Alberto-M11/Alberto_Mendez_Electiva_2026_C2/Tarea 1/Resumen MBSE.jpeg

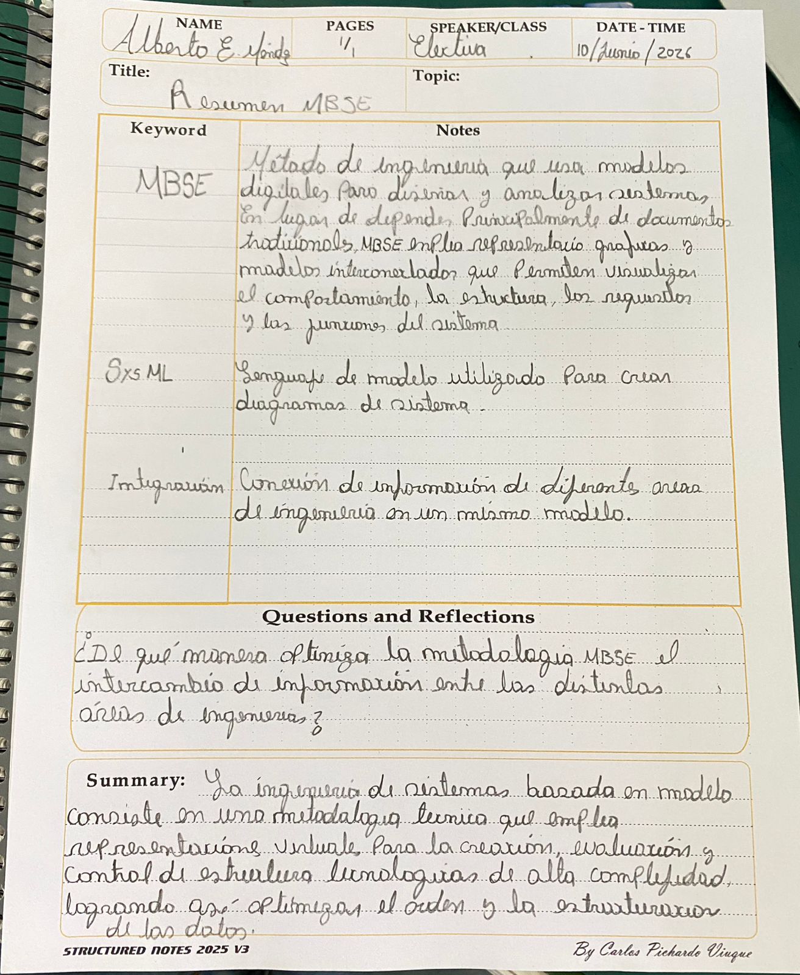
Tarea 1/Resumen MBSE.jpeg
