Alberto-M11/Alberto_Mendez_Electiva_2026_C2/README.md

# Alberto_Mendez_Electiva_2026_C2
Entrega de trabajos realizados en la materia.
