Alberto-M11/Alberto_Mendez_Electiva_2026_C2/Tarea 2/Dimensiones del PLC.jpeg

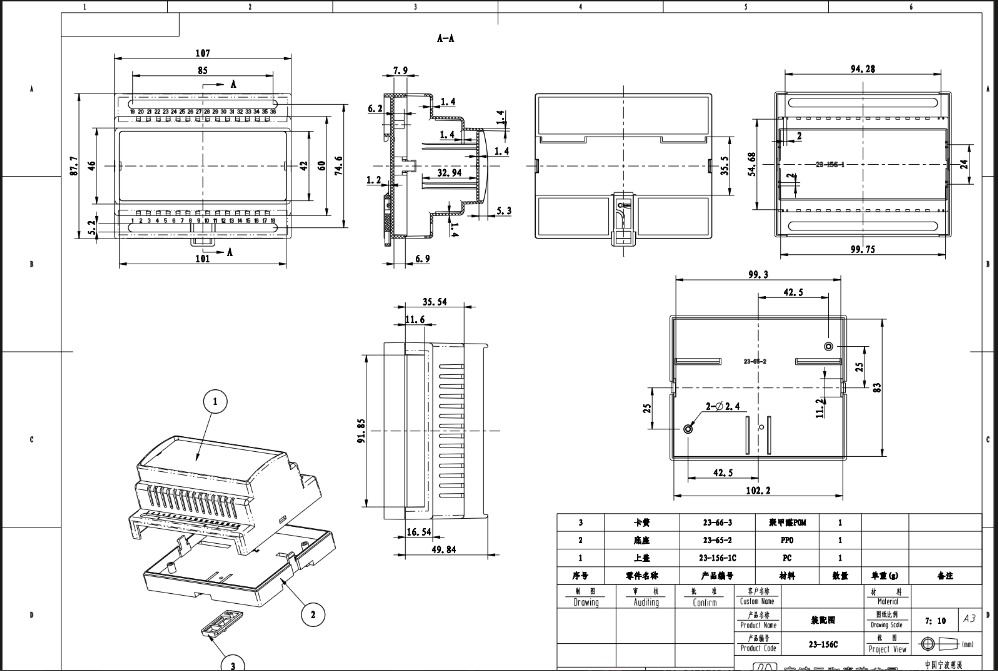
Tarea 2/Dimensiones del PLC.jpeg
