Alberto-M11/Alberto_Mendez_Electiva_2026_C2/Tarea 2/Parte Superior.FCStd

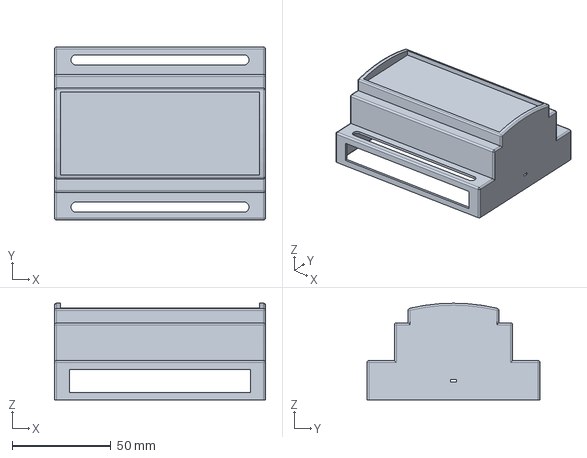
[picture p4: CAD file, 2026-07-27]
Tarea 2/Parte Superior.FCStd
107.0 x 87.7 x 49.0 mm
