Alberto-M11/Alberto_Mendez_Electiva_2026_C2/Tarea 2/Base del PLC.FCStd

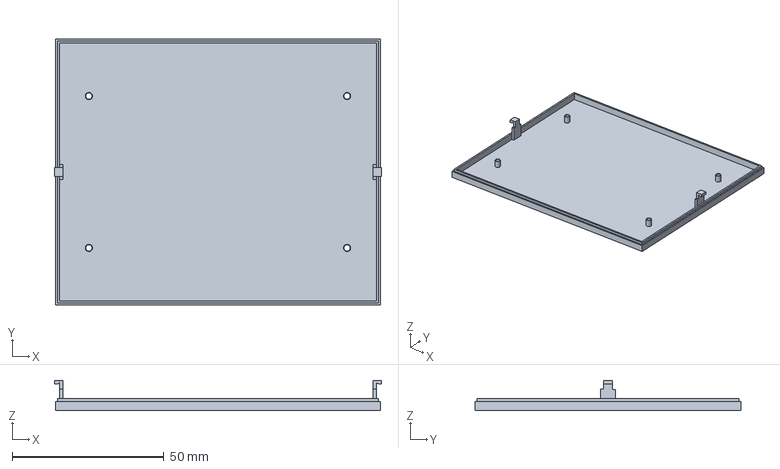
[picture p6: CAD file, 2026-06-11]
Tarea 2/Base del PLC.FCStd
107.6 x 87.7 x 10.0 mm
