Alberto-M11/Alberto_Mendez_Electiva_2026_C2/Tarea 2/Parte Superior en proceso.FCStd

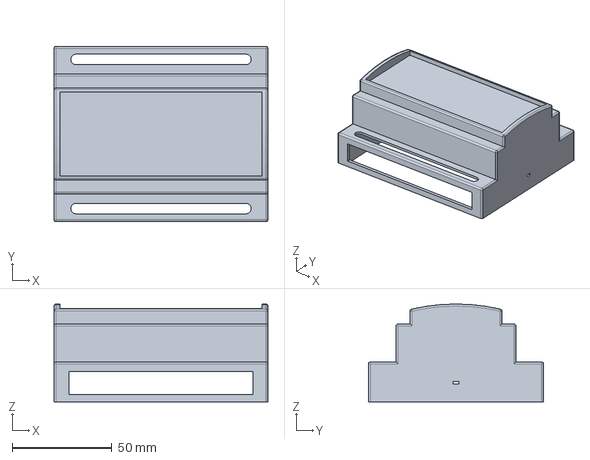
[picture p7: CAD file, 2026-06-11]
Tarea 2/Parte Superior en proceso.FCStd
107.0 x 87.7 x 49.0 mm
