Alberto-M11/Alberto_Mendez_Electiva_2026_C2/Tarea 5/PLC4UNI-GC1_3D/Base Del Case Plástico.FCStd

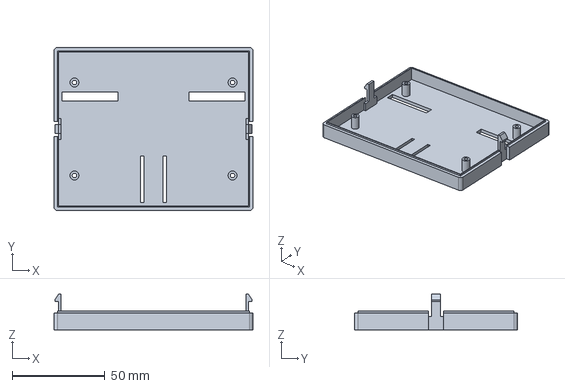
[picture p8: CAD file, 2026-08-04]
Tarea 5/PLC4UNI-GC1_3D/Base Del Case Plástico.FCStd
107.0 x 87.7 x 19.1 mm
