Alberto-M11/Alberto_Mendez_Electiva_2026_C2/Tarea 5/PLC4UNI-GC1_3D/PLC4UNI-PCB.FCStd

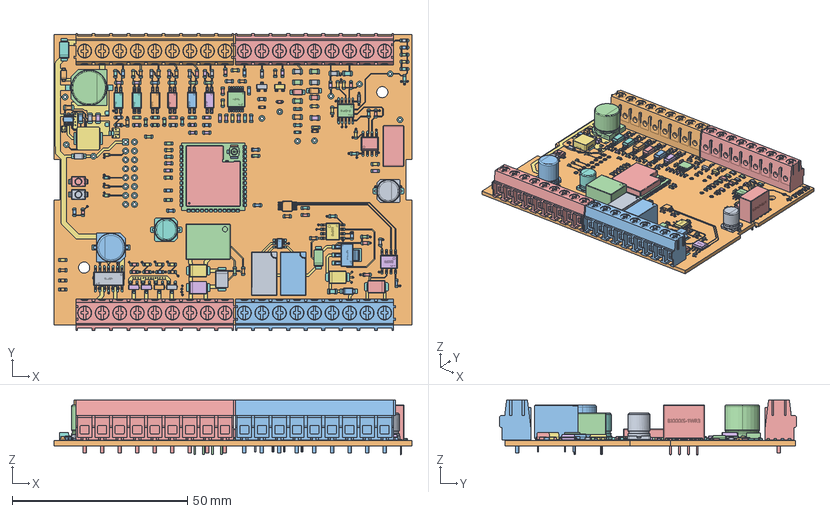
[picture p9: CAD file, 2026-08-04]
Tarea 5/PLC4UNI-GC1_3D/PLC4UNI-PCB.FCStd
102.1 x 84.7 x 15.6 mm
R_0603_1608Metric
R_0603_1608Metric002
CAP-SMD_BD8.0-L8.3-W8.3-FD
R_0603_1608Metric004
R_0603_1608Metric006
ESOP-8_L4.9-W3.9-H1.6-LS6.0-P1.27
C_0603_1608Metric
C_0603_1608Metric002
LED_0603_1608Metric
LED_0603_1608Metric002
LED_0603_1608Metric004
C_0603_1608Metric004
R_0805_2012Metric
R_0603_1608Metric008
IND-SMD_L7.0-W6.6_APH0630
R_0603_1608Metric010
LED_0603_1608Metric006
C_0805_2012Metric
SOD-123_L2.8-W1.8-LS3.9-FD
R_0603_1608Metric012
R_0603_1608Metric014
SOT-23-3
C_0603_1608Metric006
C_0603_1608Metric008
R_0603_1608Metric016
TerminalBlock_Phoenix_PT-1,5-9-5.0-H_1x09_P5.00mm_Horizontal
LED_0603_1608Metric008
COMM-TH_L12.7-W10.2-H7.7-TD301M485
LED_0603_1608Metric010
R_0603_1608Metric018
D_SMB
SSOP-4_L2.7-W4.6-P1.27-LS7.0-TL
R_0805_2012Metric002
SOD-123_L2.7-W1.6-LS3.7-RD-2
Relay_SPDT_Omron_G5V-1
R_0805_2012Metric004
R_0603_1608Metric020
D_SMB002
R_0603_1608Metric022
R_0805_2012Metric006
C_0603_1608Metric010
D_SOD_523
R_0603_1608Metric024
R_0805_2012Metric008
TerminalBlock_Phoenix_PT-1,5-9-5.0-H_1x09_P5.00mm_Horizontal002
SOT-23-002
C_0603_1608Metric012
SSOP-4_L2.7-W4.6-P1.27-LS7.0-TL002
Relay_SPDT_Omron_G5V-002
R_0603_1608Metric026
SOT-223-4P_L6.5-W3.5-H1.6-LS7.0-P2.30
R_0603_1608Metric028
SOD-123_L2.7-W1.6-LS3.7-RD-001
R_0603_1608Metric030
D_SOD_524
C_0603_1608Metric014
SOT-23-004
R_0603_1608Metric032
R_0603_1608Metric034
R_0805_2012Metric010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
