Alberto-M11/Alberto_Mendez_Electiva_2026_C2/(list of files, cad)

Other CAD files:
Tarea 5/PLC4UNI-GC1_3D/PLC4UNI-Assembly.step
Tarea 5/PLC4UNI-GC1_3D/PLC4UNI_MEZZANINE.step
Tarea 5/PLC4UNI-GC1_3D/PLC4UNI.step
Tarea 5/PLC4UNI-GC1_3D/PLC4UNI.FCStd
Tarea 5/PLC4UNI-GC1_3D/PLC4UNI_MEZZANINE.FCStd
