Alberto-M11/Alberto_Mendez_Electiva_2026_C2/Tarea 5/BASE DE PLASTICO PLC4UNI Dimensiones.pdf

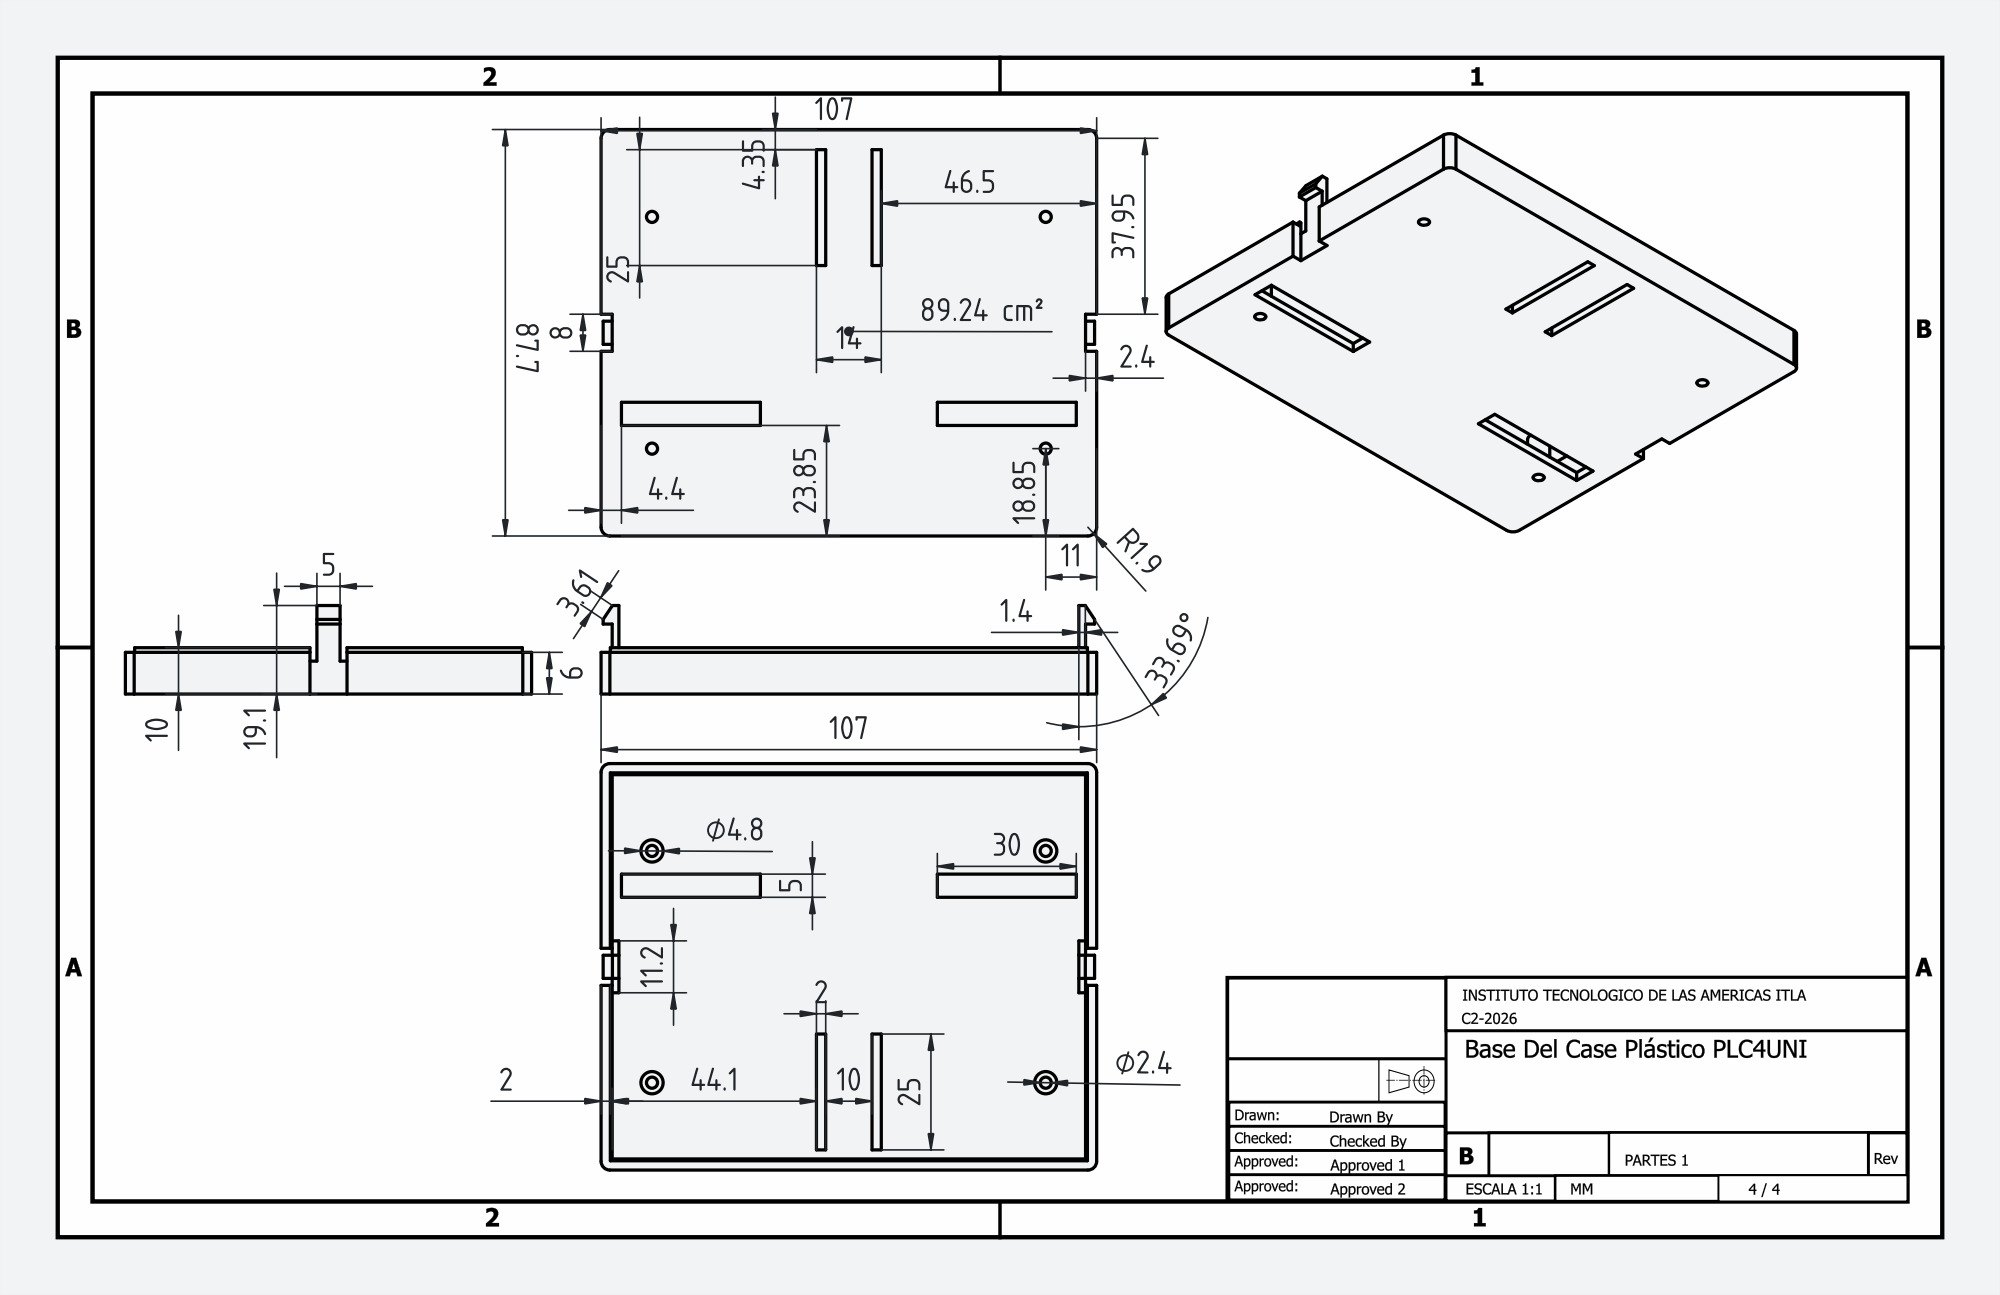
[picture p10: page 1]
