Alberto-M11/Alberto_Mendez_Electiva_2026_C2/Tarea 5/TAPA CASE DE PLASTICO PLC 4UNI.pdf

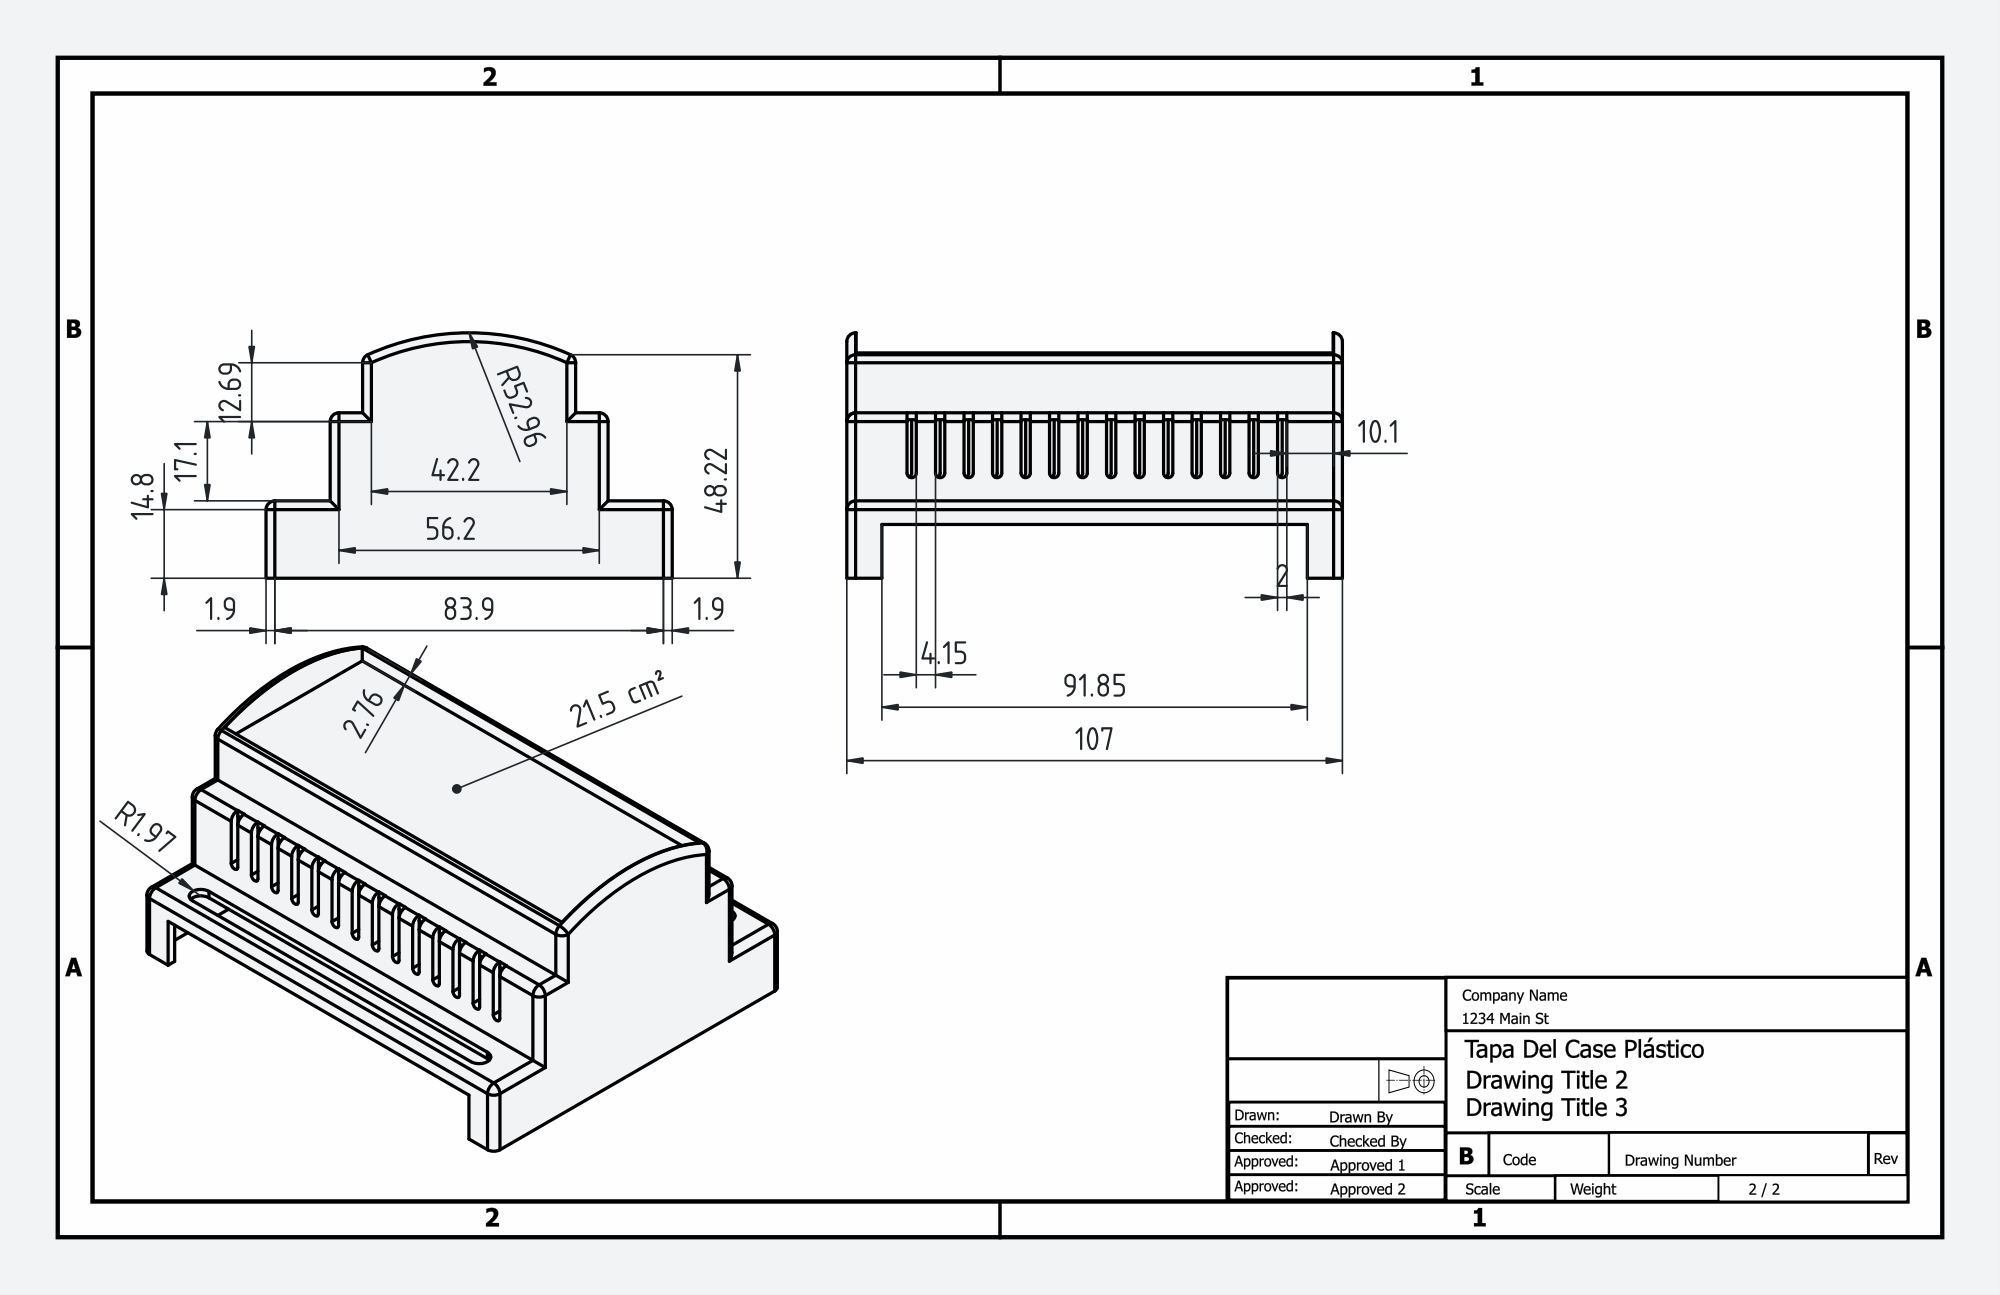
[picture p11: page 1]
