Alberto-M11/Alberto_Mendez_Electiva_2026_C2/Tarea 3 y 4/PLC4UNI-GC1_PCB/PLC4UNI-GC1.kicad_pcb

## KiCad design Tarea 3 y 4/PLC4UNI-GC1_PCB/PLC4UNI-GC1.kicad_pcb (continued)

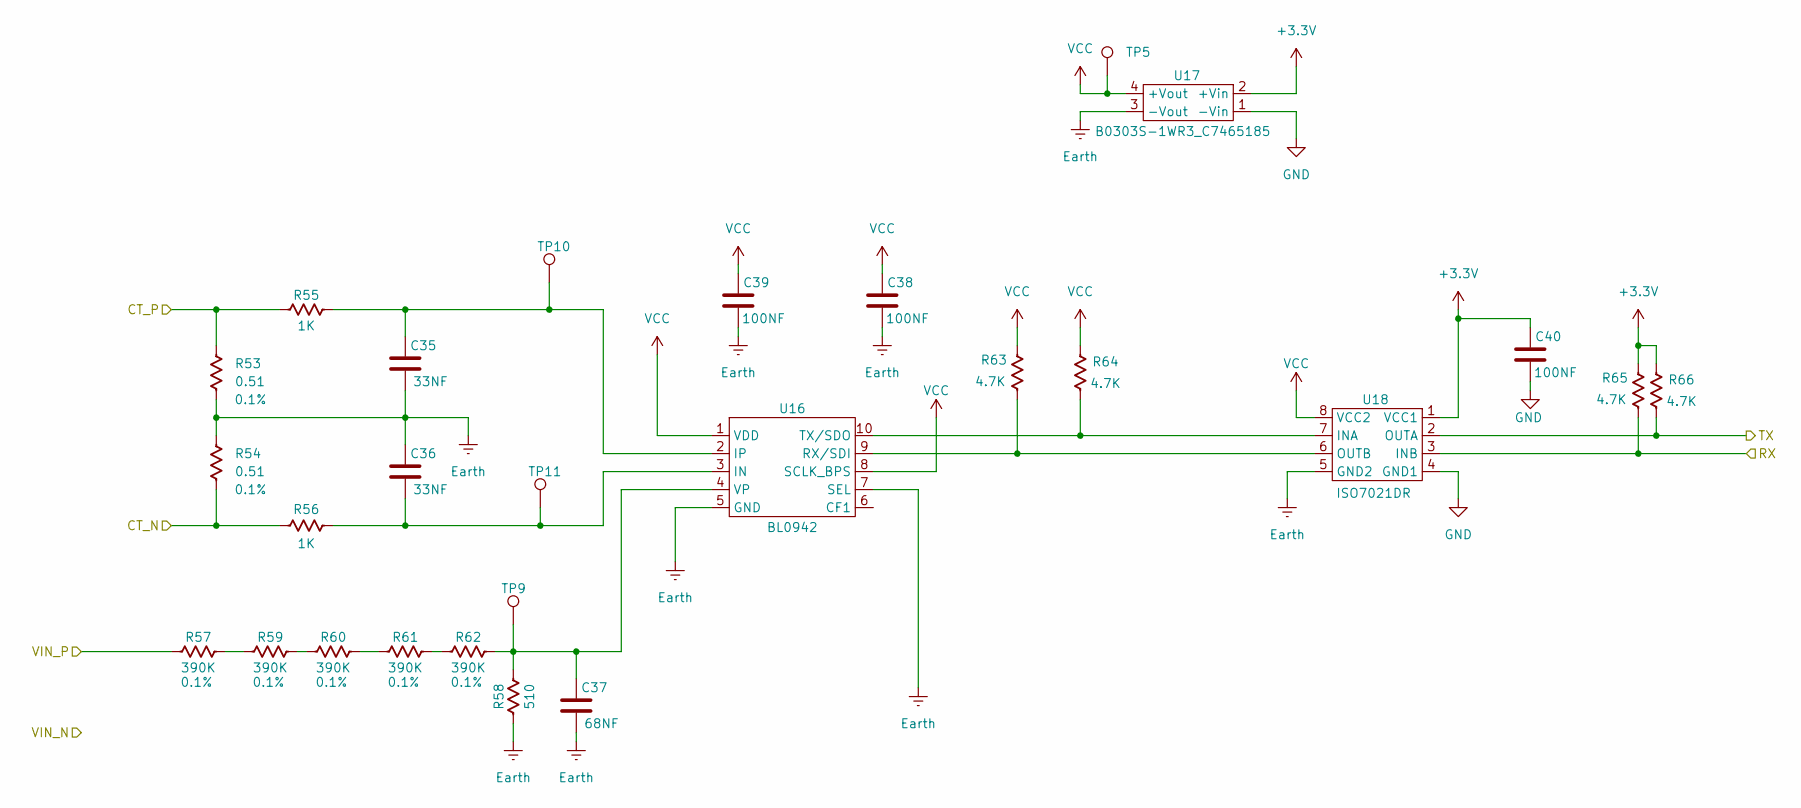
[picture p24: schematic EnergyMeterA1.kicad_sch]

Parts:
C35, C36: 33NF; C_0603_1608Metric
C37: 68NF; C_0603_1608Metric
C38, C39, C40: 100NF; C_0603_1608Metric
R53, R54: 0.51; R_0805_2012Metric
R55, R56: 1K; R_0603_1608Metric
R57, R59, R60, R61, R62: 390K; R_0603_1608Metric
R58: 510; R_0603_1608Metric
R63, R64, R65, R66: 4.7K; R_0603_1608Metric
TP5, TP9, TP10, TP11: TestPoint_Hole1; TestPoint_WireHole
U16: BL0942; SSOP-10_L4.9-W3.9-P1.00-LS6.0-BL; LCSC Part C2837510
U17: B0303S-1WR3_C7465185; PWRM-TH_BXXXXS-1WR3; LCSC Part C7465185
U18: ISO7021DR; SOIC-8_L4.9-W3.9-P1.27-LS6.0-BL; LCSC Part C2867957

Connections:
+3.3V: C40.2, R65.2, R66.2, U17.2 (+Vin), U18.1 (VCC1); also elsewhere on the board
/control/CON-IN_CT_N: R54.2, R56.1; also elsewhere on the board
/control/CON-IN_CT_P: R53.1, R55.1; also elsewhere on the board
/control/CON-IN_VAC_P: R57.1; also elsewhere on the board
/control/EMRX: R66.1, U18.2 (OUTA); also elsewhere on the board
/control/EM_TX: R65.1, U18.3 (INB); also elsewhere on the board
Earth: C35.1, C36.2, C37.1, C38.1, C39.1, R53.2, R54.1, R58.1, U16.5 (GND), U16.7 (SEL), U17.3 (-Vout), U18.5 (GND2); also elsewhere on the board
GND: C40.1, U17.1 (-Vin), U18.4 (GND1); also elsewhere on the board
unnamed: R57.2, R59.1
unnamed: R59.2, R60.1
unnamed: R60.2, R61.1
unnamed: R61.2, R62.1
unnamed: C36.1, R56.2, TP11.1 (1_1), U16.3 (IN)
unnamed: C35.2, R55.2, TP10.1 (1_1), U16.2 (IP)
unnamed: R63.1, U16.9 (RX/SDI), U18.6 (OUTB)
unnamed: R64.1, U16.10 (TX/SDO), U18.7 (INA)
unnamed: C37.2, R58.2, R62.2, TP9.1 (1_1), U16.4 (VP)
VCC: C38.2, C39.2, R63.2, R64.2, TP5.1 (1_1), U16.1 (VDD), U16.8 (SCLK_BPS), U17.4 (+Vout), U18.8 (VCC2)

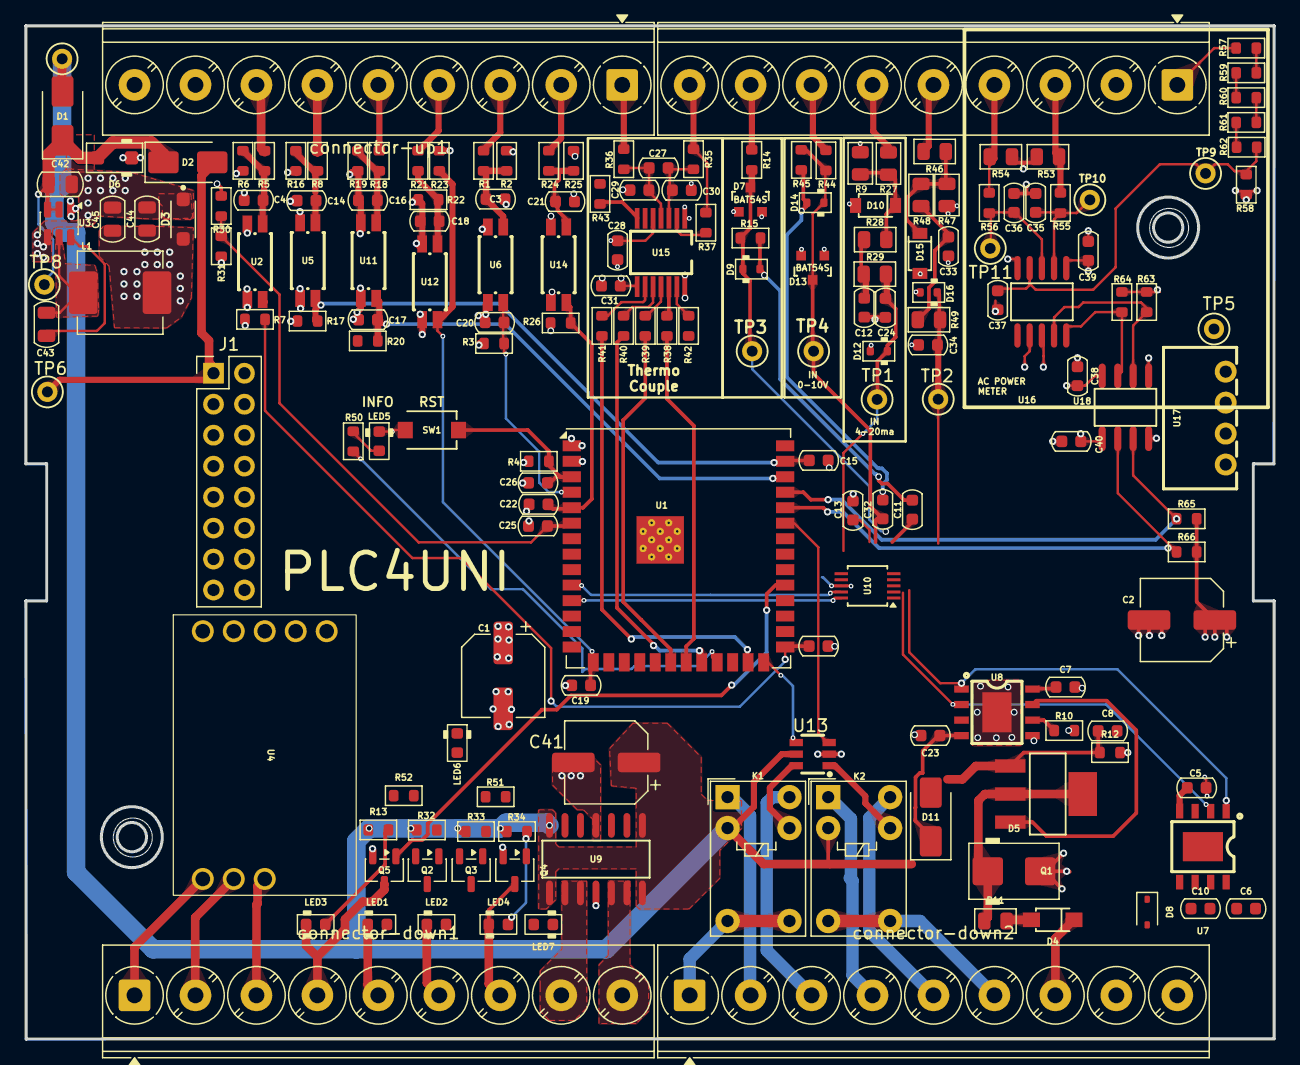
[picture p25: board PLC4UNI-GC1.kicad_pcb from above]

Board: 4 copper layers, 102.4 x 83.1 mm, 179 parts (0 on the bottom side), 116 nets.
