Alberto-M11/Alberto_Mendez_Electiva_2026_C2/(commit log)

2026-06-11 diseño en proceso
    [Base del PLC.FCStd, Parte Superior en proceso.FCStd]
2026-07-27 Parte Superior .FCStd
    [Parte Superior.FCStd]
2026-08-03 Agrega la carpeta Tarea 3 y 4
    [EnergyMeterA1.kicad_sch, IN-0-10V.kicad_sch, IN-4-20MA.kicad_sch, IN-DI.kicad_sch, IN-NPN-OPTO.kicad_sch, IN-PNP-OPTO.kicad_sch, IN_NPN.kicad_sch, Input_0-10V.kicad_sch]
2026-08-04 Agregar Tarea 5
    [Base Del Case Plástico.FCStd, PLC4UNI-Assembly.step, PLC4UNI-PCB.FCStd, PLC4UNI.FCStd, PLC4UNI.step, PLC4UNI_MEZZANINE.FCStd, PLC4UNI_MEZZANINE.step, Tapa Del Case Plástico.FCStd]
2026-08-18 Actualizar diseño PCB y renombrar esquema a Alberto
    [Alberto.kicad_sch, PLC4UNI-GC1.kicad_pcb]
